georf/Garagen-Steuerung/readme.md

Read here: https://georf.de/1458/garagentor-und-garagen-tool-smart-machen/
