georf/Garagen-Steuerung/garagensteuerung/output/garagensteuerung-F_Cu.pdf

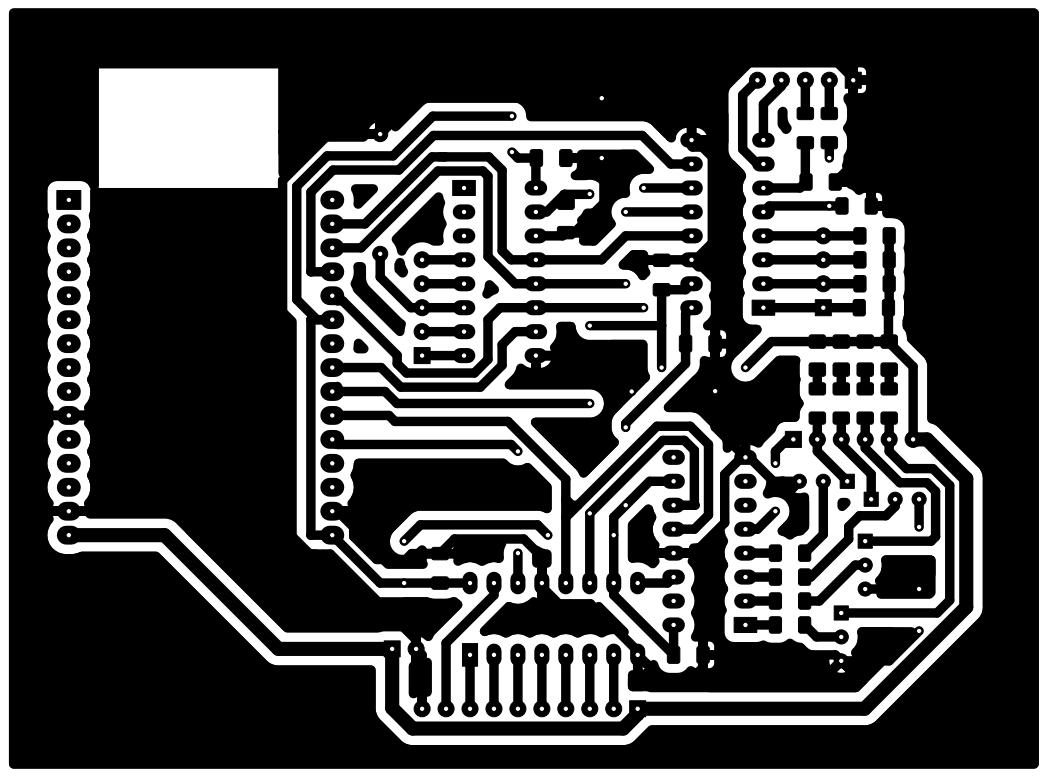
[picture p1: page 1]
