georf/Garagen-Steuerung/garagensteuerung/garagensteuerung.kicad_pcb

## KiCad design garagensteuerung/garagensteuerung.kicad_pcb (2024-02-11)

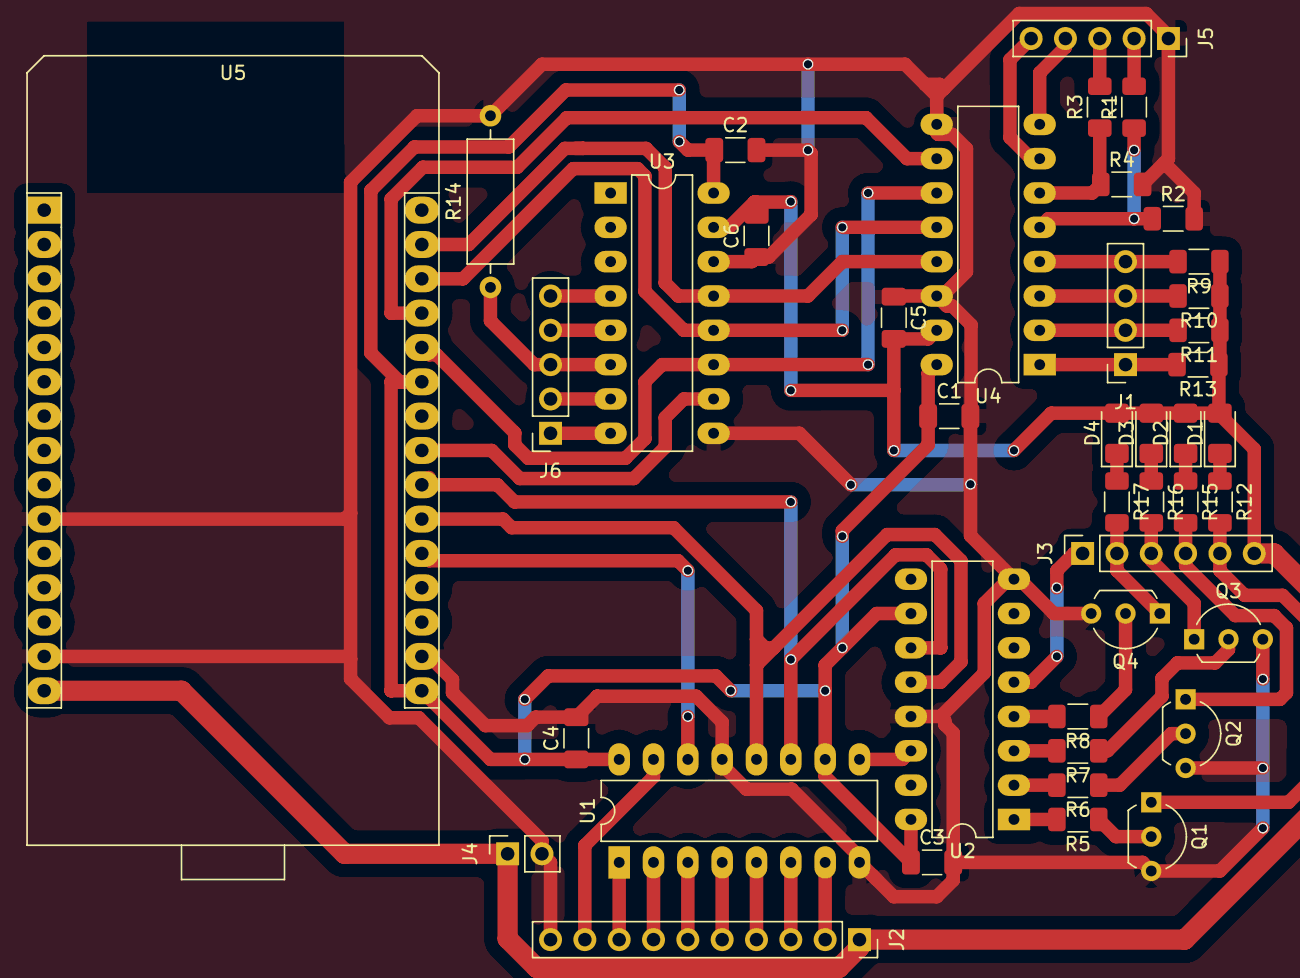
[picture p2: board garagensteuerung.kicad_pcb from above]

Board: 2 copper layers, 42 parts (0 on the bottom side), 52 nets.

Parts:
C1, C2, C3, C4, C5, C6: 1uF; C_1206_3216Metric_Pad1.33x1.80mm_HandSolder
D1, D2, D3, D4: RED; LED_1206_3216Metric_Pad1.42x1.75mm_HandSolder
J1: Conn_01x04_Female; PinSocket_1x04_P2.54mm_Vertical
J2: Relais-Connector; PinSocket_1x10_P2.54mm_Vertical
J3: Tor-Connector; PinSocket_1x06_P2.54mm_Vertical
J4: Conn_01x02_Female; PinSocket_1x02_P2.54mm_Vertical
J5: Anzeige_Connector; PinSocket_1x05_P2.54mm_Vertical
J6: Sensor_Connector; PinSocket_1x05_P2.54mm_Vertical
Q1, Q2, Q3, Q4: BC547; TO-92L_Inline_Wide
R1, R3: 75k; R_1206_3216Metric_Pad1.30x1.75mm_HandSolder
R2, R4, R5, R6, R7, R8, R9, R10, R11, R13: 15k; R_1206_3216Metric_Pad1.30x1.75mm_HandSolder
R12, R15, R16, R17: 150; R_1206_3216Metric_Pad1.30x1.75mm_HandSolder
R14: 10k; R_Axial_DIN0309_L9.0mm_D3.2mm_P12.70mm_Horizontal
U1, U2: 74HC595; DIP-16_W7.62mm_LongPads
U3, U4: MCP3008; DIP-16_W7.62mm_LongPads
U5: NodeMCU_Amica_R2; node_MCU_ESP8266_longpad

Connections:
+3V3: C1.1, C2.1, C3.1, C4.1, U1.10, U1.16, U2.10, U2.16, U3.16, U4.16, U5.16, U5.25
+5V: C5.2, C6.2, D1.2, D2.2, D3.2, D4.2, J2.1, J3.6, J4.1, R9.1, R10.1, R11.1, R13.1, U3.15, U4.15, U5.15
Anzeige_0: J3.5, Q1.1, R12.2
Anzeige_1: J3.4, Q2.1, R15.2
Anzeige_2: J3.3, Q3.1, R16.2
Anzeige_3: J3.2, Q4.1, R17.2
GND: C1.2, C2.2, C3.2, C4.2, C5.1, C6.1, J2.10, J4.2, J5.1, Q1.3, Q2.3, Q3.3, Q4.3, R2.2, R4.2, R14.2, U1.8, U1.13, U2.8, U2.13, U3.9, U3.14, U4.9, U4.14, U5.10, U5.14, U5.17
Lichtsensor: J6.3, R14.1, U3.6
MISO: U3.12, U4.12, U5.28
MOSI: U3.11, U4.11, U5.26
unnamed: D1.1, R12.1
unnamed: D2.1, R15.1
unnamed: D3.1, R16.1
unnamed: D4.1, R17.1
unnamed: J2.2, U1.7
unnamed: J2.3, U1.6
unnamed: J2.4, U1.5
unnamed: J2.5, U1.4
unnamed: J2.6, U1.3
unnamed: J2.7, U1.2
unnamed: J2.8, U1.1
unnamed: J2.9, U1.15
unnamed: J5.2, R1.2
unnamed: J5.3, R3.2
unnamed: Q1.2, R5.1
unnamed: Q2.2, R6.1
unnamed: Q3.2, R7.1
unnamed: Q4.2, R8.1
unnamed: R5.2, U2.1
unnamed: R6.2, U2.2
unnamed: R7.2, U2.3
unnamed: R8.2, U2.4
unnamed: U1.9, U2.14
SPI_CLK: U3.13, U4.13, U5.29
SPI_CS0: U3.10, U5.23
SPI_CS1: U4.10, U5.27
SRCLK: U1.11, U2.11, U5.22
SRDATA: U1.14, U5.20
SRLOAD: U1.12, U2.12, U5.21
Schalter_1: J1.2, R11.2, U4.2
Schalter_2: J1.1, R13.2, U4.1
Temperatur_0: J6.1, U3.8
Temperatur_1: J6.2, U3.7
TorEndpunkt_0: J5.5, U4.7
TorEndpunkt_1: J5.4, U4.8
TorMotor_0: R1.1, R2.1, U4.5
TorMotor_1: R3.1, R4.1, U4.6
TorTaster: J3.1, U2.5
Tür_0: J1.4, R9.2, U4.4
Tür_1: J1.3, R10.2, U4.3
Unused_0: J6.4, U3.5
Unused_1: J6.5, U3.4
