georf/Garagen-Steuerung/(commit log)

2024-02-11 Version 1
    [garagensteuerung.kicad_pcb, garagensteuerung.sch]
2024-02-14 Neue Kicad-Version
